IEEEsb/Sumobots/Hardware/Hojas de características/Motores.pdf

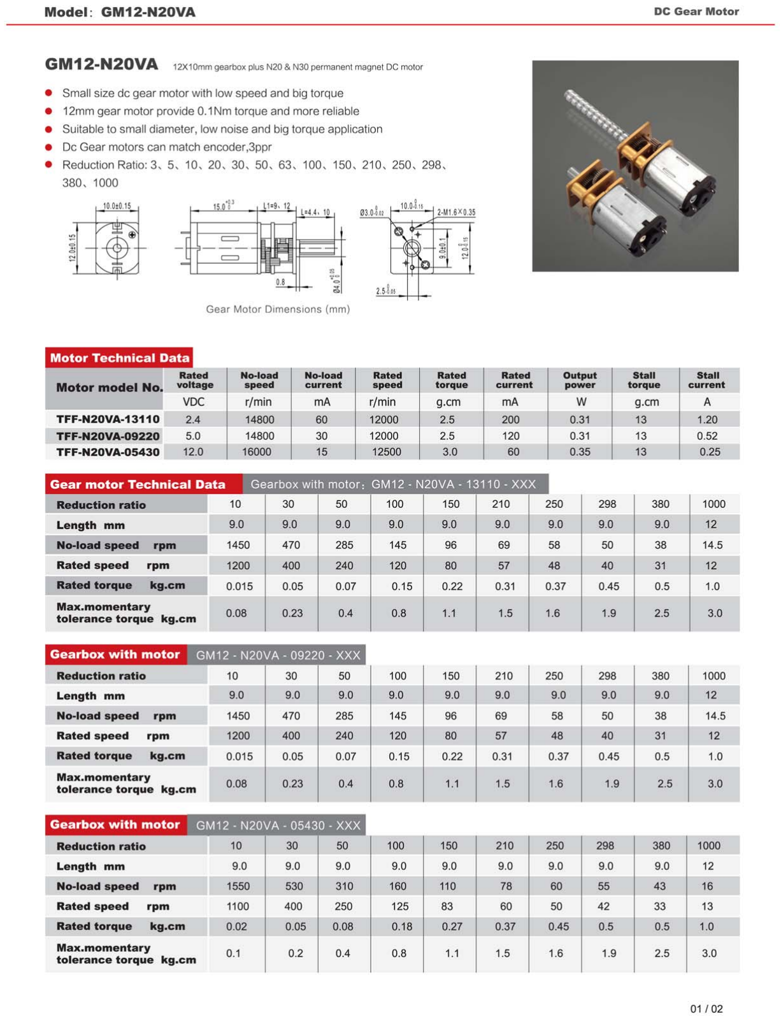
[picture p1: page 1]
