IEEEsb/Sumobots/Hardware/Esquemas y PCB/ListaComponentes.xlsx

Componente | Referencia | Cantidad
Arduino Nano V3.0 | - | 1
Caja cartón 10x10x12cm | - | 1
Condensador cerámico 100nF 1206 X7R 20% | C1,C2 (ppal) | 2
Cuchilla 100x37,5mm FR4 1,9mm | - | 1
Interruptor mod. SK12D07VG3 | SW1 | 1
L293D | IC1 | 1
LED RGB 5mm cátodo común | LED1 | 1
Motor 6-12V DC mod. N20 reductora 1:150 eje 10mm | MOTOR_IZQUIERDO, MOTOR_DERECHO | 2
PCB principal | - | 1
PCB sensores | - | 1
Pila alkalina AA 1,5V LR06 | - | 5
Portapilas 5X AA | - | 1
Pulsador táctil 6x6x5mm | S1(ppal) | 1
Pulsera silicona 10mm x 200mm lisa | - | 2
QRE1113GR | S1,S2 (sensores) | 2
Resistencia 100ohm 1206 5% | R3,R4 (ppal), R1(sensores) | 2
Resistencia 10k 1206 5% | R1 (ppal) | 1
Resistencia 200ohm 1206 5% | R5 (ppal) | 1
Resistencia 47k 1206 5% | R2,R3 (sensores) | 2
Rueda 65mm impresa 3D PLA | - | 2
Sensor de distancia ultrasónico HC-SR04 | - | 1
Separador hexagonal M3x20mm hembra-hembra nylon | - | 4
Soporte motores N20 Dfrobots | MOTOR_IZQUIERDO, MOTOR_DERECHO | 2
Tira pin hembra 15pos 2,54mm | HEAD-15-NOSS-1, HEAD-15-NOSS | 2
Tira pin hembra 4pos 2,54mm | SV4 ó SV7 | 1
Tira pin hembra 5pos 2,54mm | J4(ppal) J5(sensores) | 2
Tira pin macho-macho 5pos 2,54mm | - | 2
Tornillo Pan Head M2x8mm | - | 4
Tornillo Pan Head M3x5mm | - | 8
Tuerca M2 | - | 4
Zócalo DIP 16 pin plano | IC1 | 1
