IEEEsb/Sumobots/Hardware/Esquemas y PCB/placappal.pdf

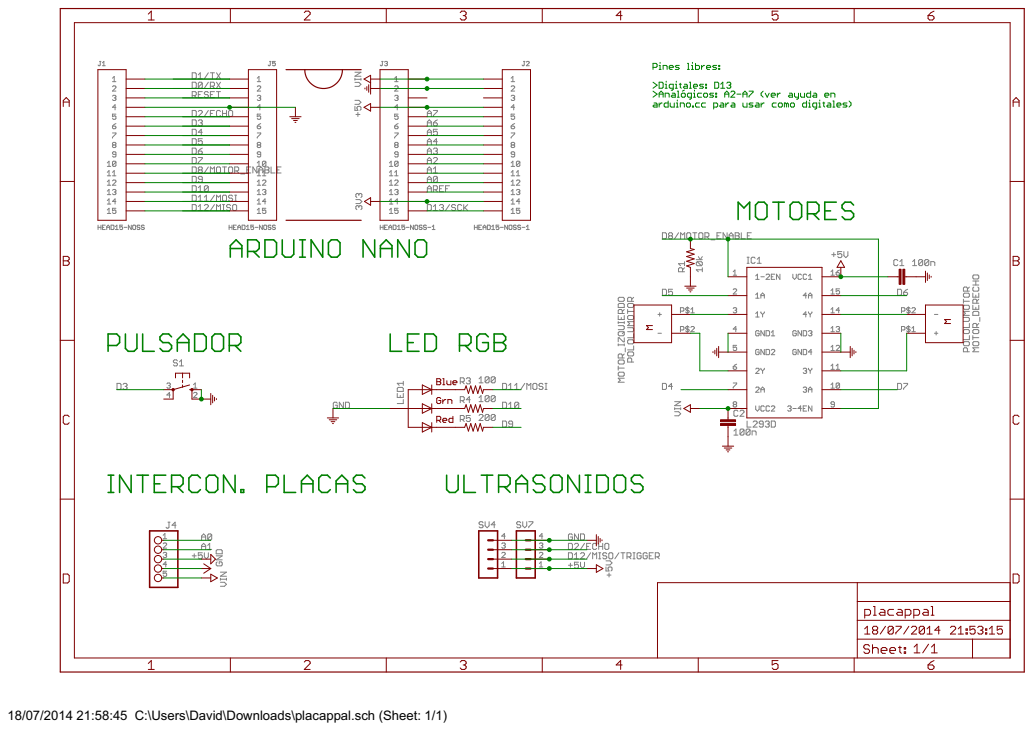
[picture p2: page 1]

18/07/2014 21:58:45 C:\Users\David\Downloads\placappal.sch (Sheet: 1/1)
