IEEEsb/Sumobots/Hardware/Esquemas y PCB/placasensores.pdf

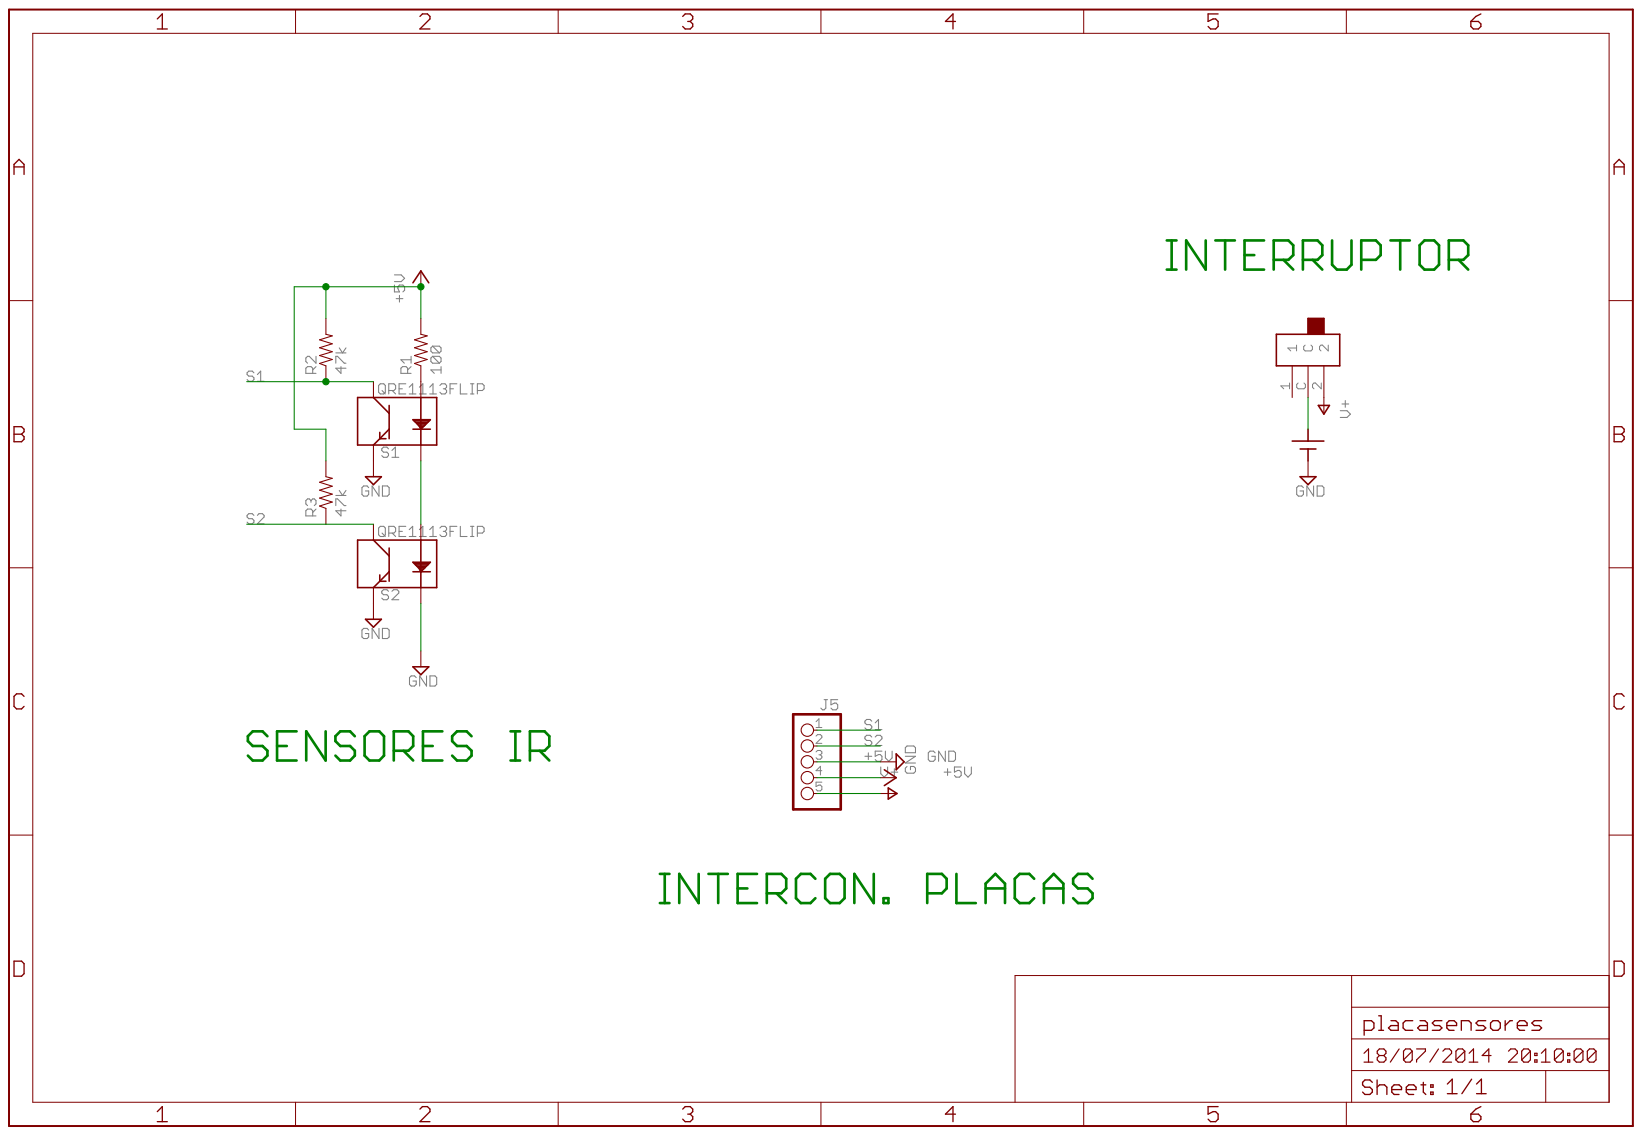
[picture p3: page 1]
