IEEEsb/Sumobots/Hardware/Esquemas y PCB/placasensores.brd

## EAGLE design Hardware/Esquemas y PCB/placasensores.brd (2014-07-18)

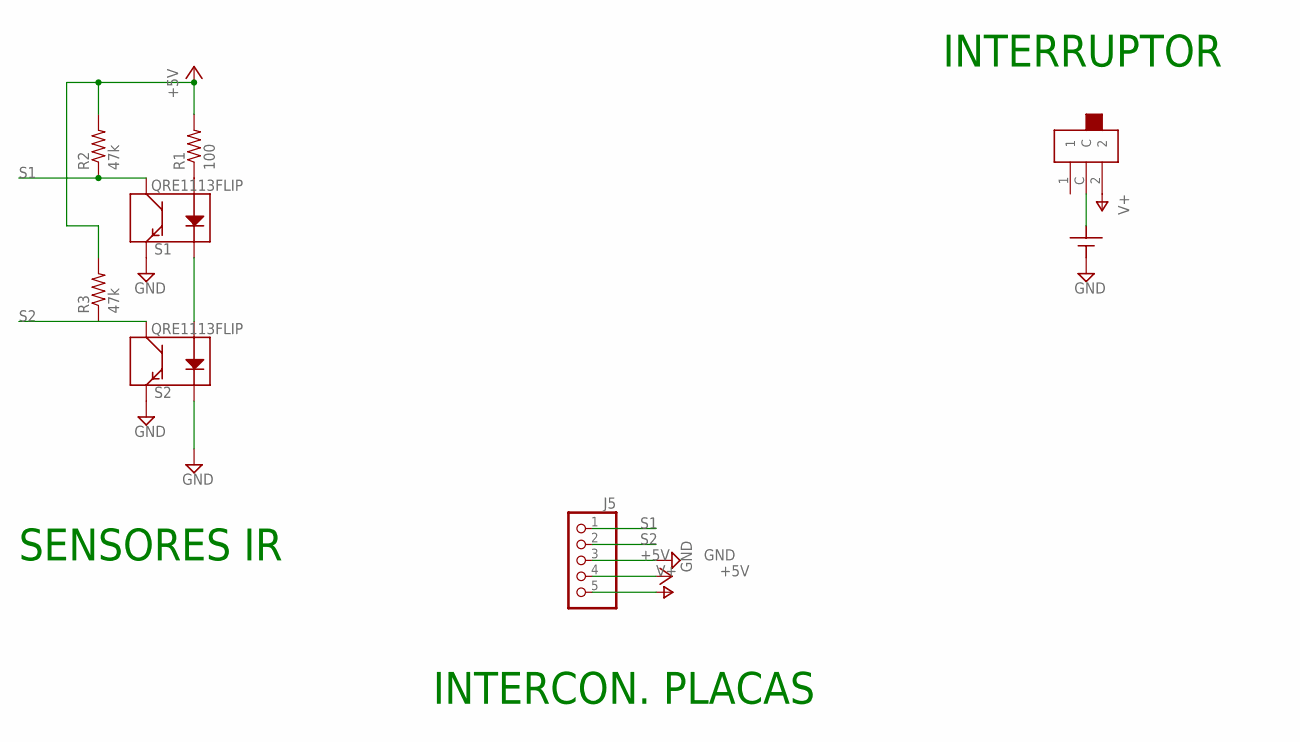
[picture p4: schematic placasensores.sch]

Parts:
J5: PINHD-1X5; 1X05
R1: 100; 1206
R2, R3: 47k; 1206
S1, S2: QRE1113FLIP; QRE1113GR_HOLE
SW1: SK-12D07G3
U$3: 5XAA; 5XAAHOLDER

Connections:
+5V: J5.4, R1.2, R2.2, R3.2
GND: J5.3, S1.E, S2.E, S2.K, U$3.P$2
unnamed: S1.K, S2.A
unnamed: R1.1, S1.A
unnamed: SW1.C, U$3.P$1
S1: J5.1, R2.1, S1.C
S2: J5.2, R3.1, S2.C
V+: J5.5, SW1.2

Notes on the sheet:
SENSORES IR
INTERCON. PLACAS
INTERRUPTOR

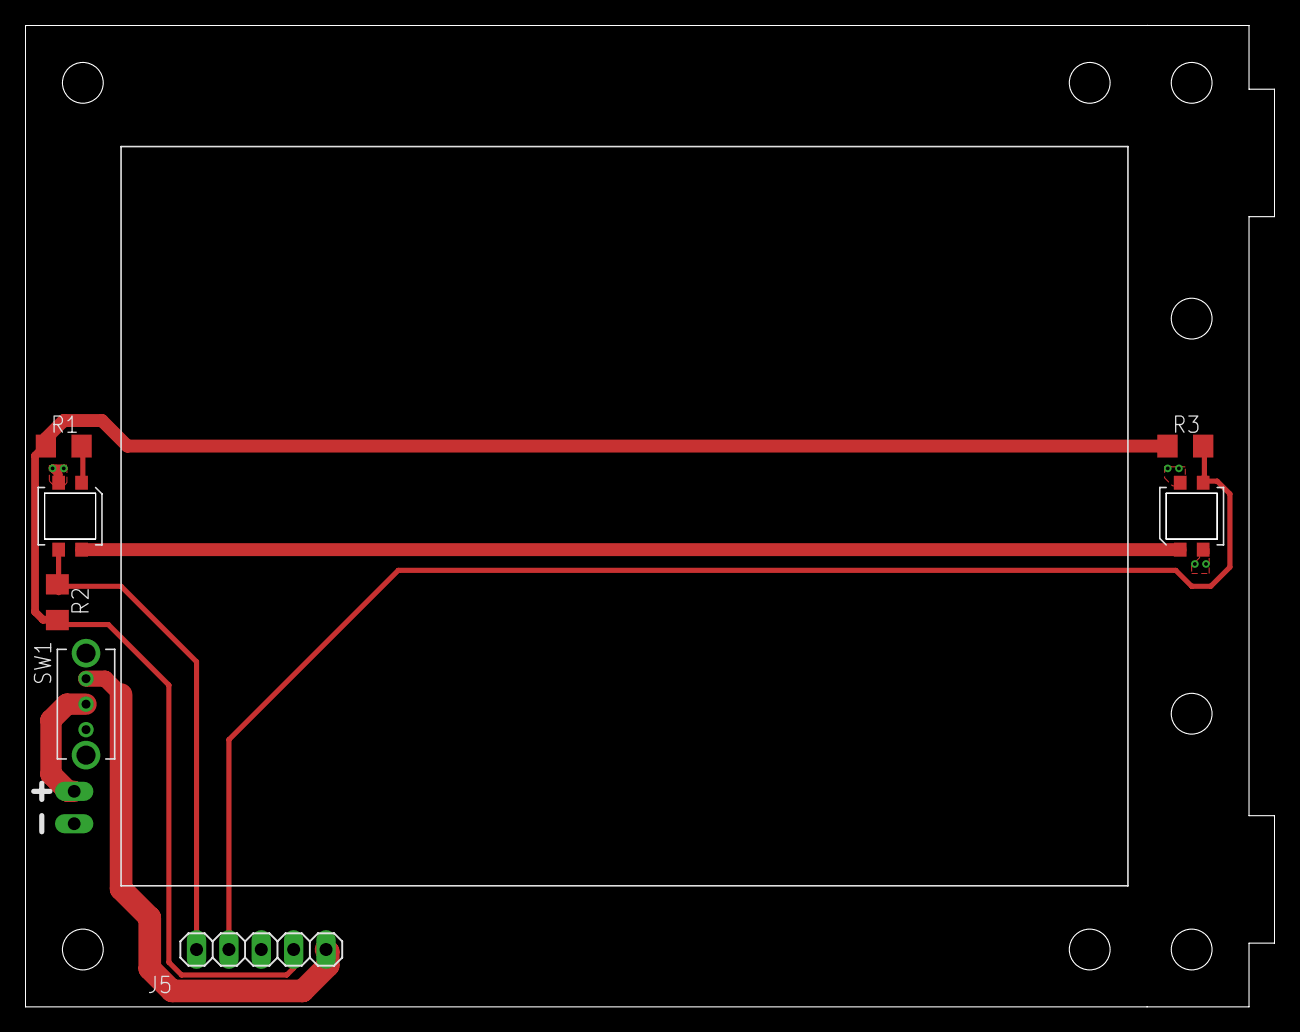
[picture p5: board placasensores.brd from above]

Board: 2 copper layers, 98.0 x 77.0 mm, 8 parts (0 on the bottom side), 8 nets.
