IEEEsb/Sumobots/Hardware/Esquemas y PCB/placappal.brd

## EAGLE design Hardware/Esquemas y PCB/placappal.brd (2014-07-18)

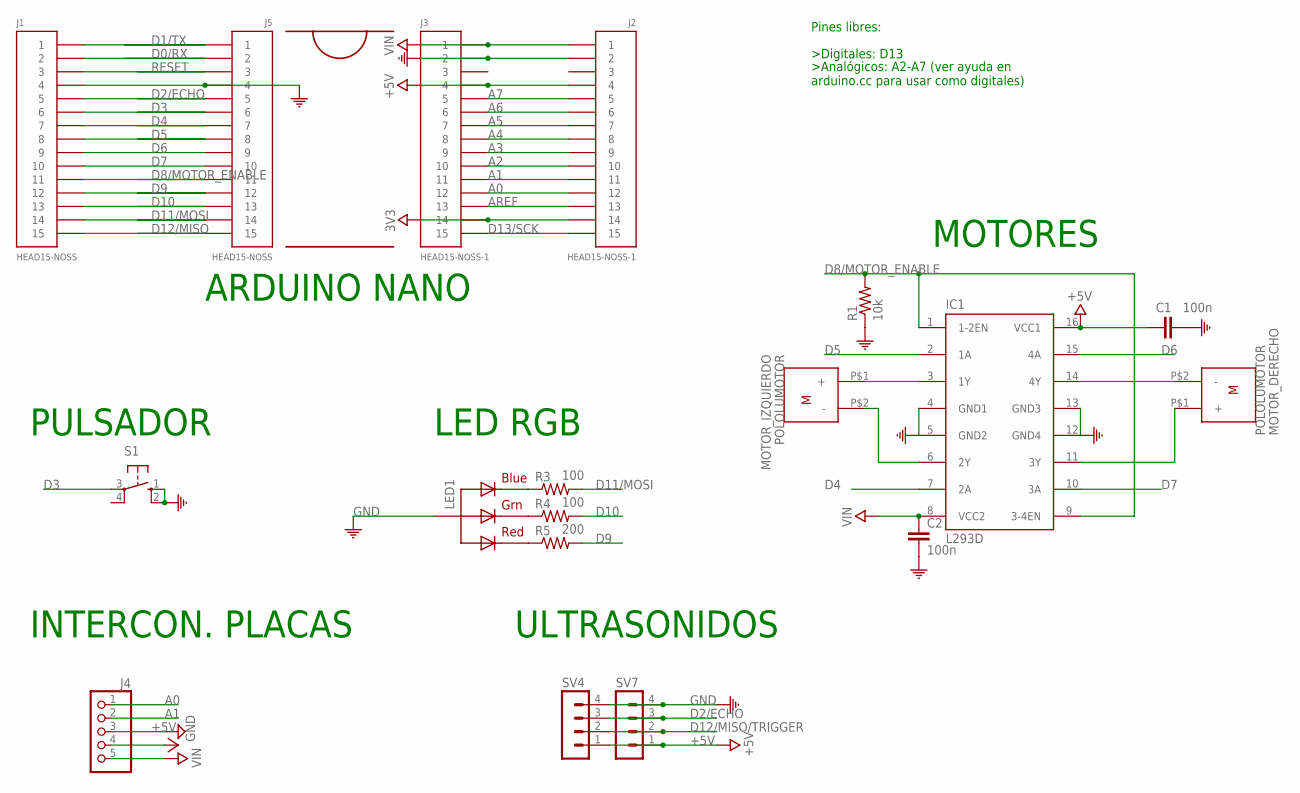
[picture p6: schematic placappal.sch]

Parts:
C1, C2: 100n; 1206
IC1: L293D; DIL16
J1, J5: HEAD15-NOSS
J2, J3: HEAD15-NOSS-1
J4: PINHD-1X5; 1X05
LED1: RGBLED_CA-5MM; LED5MMRGB
MOTOR_DERECHO: POLOLUMOTOR; N20MOTOR
MOTOR_IZQUIERDO: POLOLUMOTOR; N20MOTOR
R1: 10k; 1206
R3, R4: 100; 1206
R5: 200; 1206
S1: 10-XX; B3F-10XX
SV4, SV7: MA04-1

Connections:
3V3: J2.14, J3.14
+5V: C1.2, IC1.16 (VCC1), J2.4, J3.4, J4.4, SV4.1, SV7.1
A0: J2.12, J3.12, J4.1
A1: J2.11, J3.11, J4.2
A2: J2.10, J3.10
A3: J2.9, J3.9
A4: J2.8, J3.8
A5: J2.7, J3.7
A6: J2.6, J3.6
A7: J2.5, J3.5
AREF: J2.13, J3.13
D0/RX: J1.2, J5.2
D1/TX: J1.1, J5.1
D2/ECHO: J1.5, J5.5, SV4.3, SV7.3
D3: J1.6, J5.6, S1.3
D4: IC1.7 (2A), J1.7, J5.7
D5: IC1.2 (1A), J1.8, J5.8
D6: IC1.15 (4A), J1.9, J5.9
D7: IC1.10 (3A), J1.10, J5.10
D8/MOTOR_ENABLE: IC1.1 (1-2EN), IC1.9 (3-4EN), J1.11, J5.11, R1.2
D9: J1.12, J5.12, R5.2
D10: J1.13, J5.13, R4.2
D11/MOSI: J1.14, J5.14, R3.2
D12/MISO: J1.15, J5.15
D12/MISO/TRIGGER: SV4.2, SV7.2
D13/SCK: J2.15, J3.15
GND: C1.1, C2.2, IC1.4 (GND1), IC1.5 (GND2), IC1.12 (GND4), IC1.13 (GND3), J1.4, J2.2, J3.2, J4.3, J5.4, LED1.2 (VCC), R1.1, S1.1 (S), S1.2 (S1), SV4.4, SV7.4
unnamed: IC1.3 (1Y), MOTOR_IZQUIERDO.P$1 (+)
unnamed: IC1.6 (2Y), MOTOR_IZQUIERDO.P$2 (-)
unnamed: IC1.14 (4Y), MOTOR_DERECHO.P$2 (-)
unnamed: IC1.11 (3Y), MOTOR_DERECHO.P$1 (+)
unnamed: LED1.4 (BLUE), R3.1
unnamed: LED1.3 (GREEN), R4.1
unnamed: LED1.1 (RED), R5.1
RESET: J1.3, J5.3
VIN: C2.1, IC1.8 (VCC2), J2.1, J3.1, J4.5

Notes on the sheet:
ARDUINO NANO
PULSADOR
LED RGB
INTERCON. PLACAS
ULTRASONIDOS
MOTORES
Pines libres:

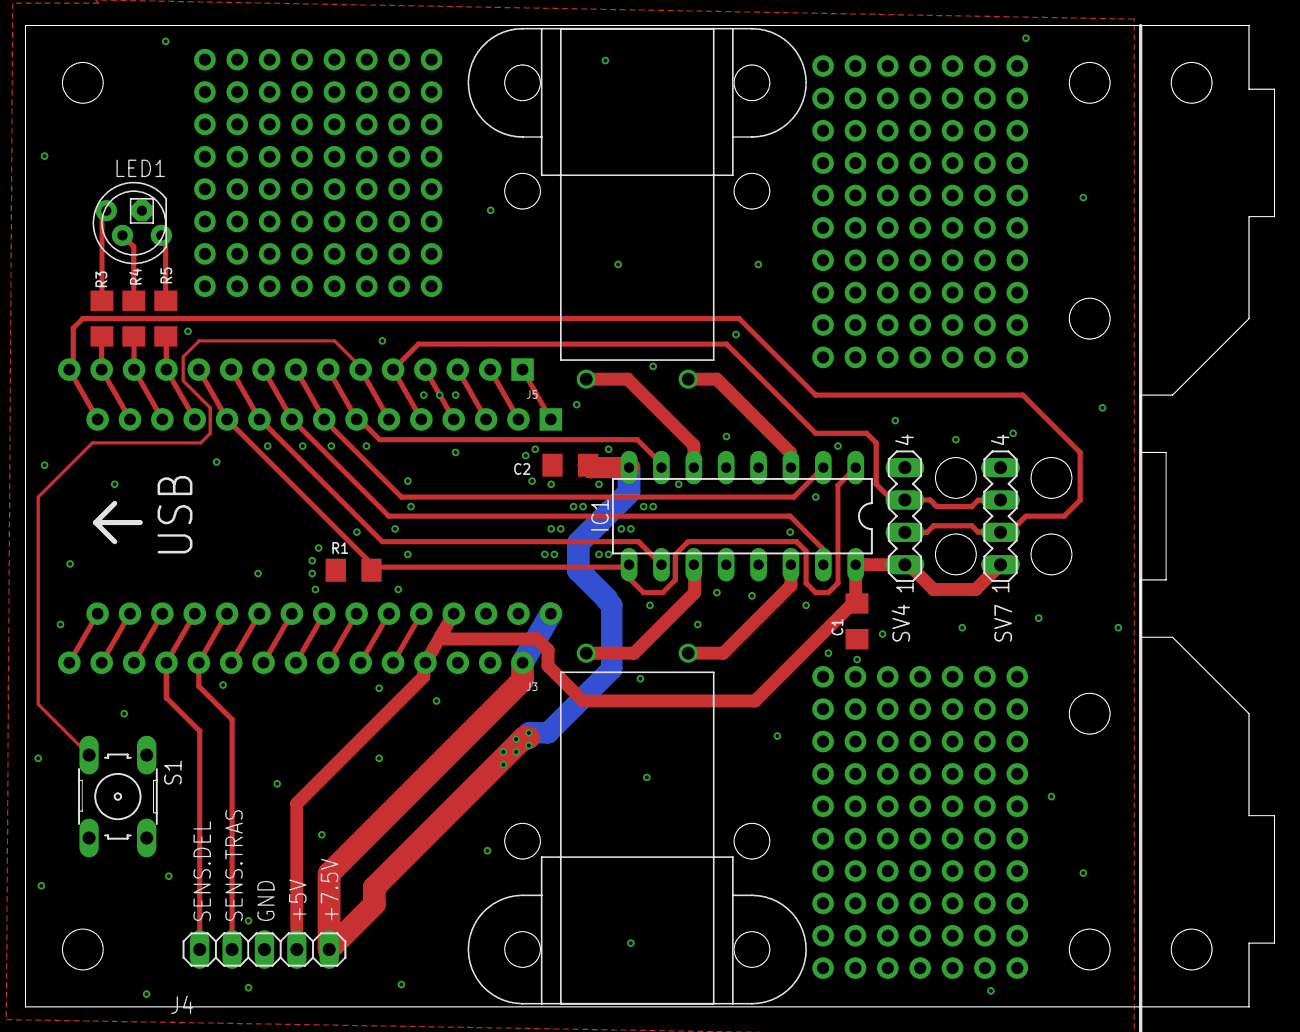
[picture p7: board placappal.brd from above]

Board: 2 copper layers, 98.0 x 77.0 mm, 18 parts (0 on the bottom side), 36 nets.
